OhioIon/zynqFC/_hw/HOWTO.md

/// Open the KiCad project ///
- Open the project file zynqAIO.pro with KiCad 5.0.2
