OhioIon/zynqFC/_sw/HOWTO.md

/// Recreate SDK project after fresh git clone ///
- Please execute the steps in _fpga/HOWTO.md first (recreate project, generate bitstream, export to SDK)
- import the standalone_bsp_0 project 
- Wait until build of BSP sources is success!!!
- Now import the app (flight controller) and fsbl (bootloader from Xilinx) into Eclipse/SDK
