OhioIon/zynqFC/_hw/zynqAIO_CAM.sch

## KiCad design _hw/zynqAIO_CAM.sch (2018-11-11)

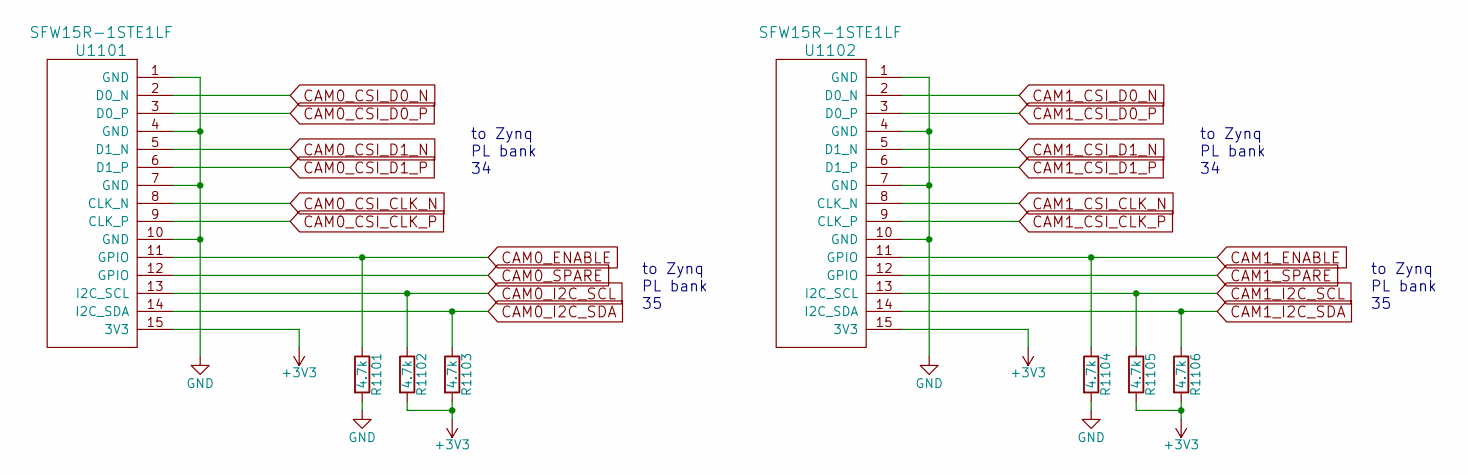
[picture p1: schematic zynqAIO_CAM.sch]

Parts:
R1101, R1102, R1103, R1104, R1105, R1106: 4.7k
U1101, U1102: SFW15R-1STE1LF

Connections:
+3V3: R1102.2, R1103.2, R1105.2, R1106.2, U1101.15 (3V3), U1102.15 (3V3)
CAM0_CSI_CLK_N: U1101.8 (CLK_N)
CAM0_CSI_CLK_P: U1101.9 (CLK_P)
CAM0_CSI_D0_N: U1101.2 (D0_N)
CAM0_CSI_D0_P: U1101.3 (D0_P)
CAM0_CSI_D1_N: U1101.5 (D1_N)
CAM0_CSI_D1_P: U1101.6 (D1_P)
CAM0_ENABLE: R1101.1, U1101.11 (GPIO)
CAM0_I2C_SCL: R1102.1, U1101.13 (I2C_SCL)
CAM0_I2C_SDA: R1103.1, U1101.14 (I2C_SDA)
CAM0_SPARE: U1101.12 (GPIO)
CAM1_CSI_CLK_N: U1102.8 (CLK_N)
CAM1_CSI_CLK_P: U1102.9 (CLK_P)
CAM1_CSI_D0_N: U1102.2 (D0_N)
CAM1_CSI_D0_P: U1102.3 (D0_P)
CAM1_CSI_D1_N: U1102.5 (D1_N)
CAM1_CSI_D1_P: U1102.6 (D1_P)
CAM1_ENABLE: R1104.1, U1102.11 (GPIO)
CAM1_I2C_SCL: R1105.1, U1102.13 (I2C_SCL)
CAM1_I2C_SDA: R1106.1, U1102.14 (I2C_SDA)
CAM1_SPARE: U1102.12 (GPIO)
GND: R1101.2, R1104.2, U1101.1 (GND), U1101.4 (GND), U1101.7 (GND), U1101.10 (GND), U1102.1 (GND), U1102.4 (GND), U1102.7 (GND), U1102.10 (GND)

Notes on the sheet:
to Zynq PL bank 35
to Zynq PL bank 34
