OhioIon/zynqFC/_hw/zynqAIO_IMU.sch

## KiCad design _hw/zynqAIO_IMU.sch (2019-08-02)

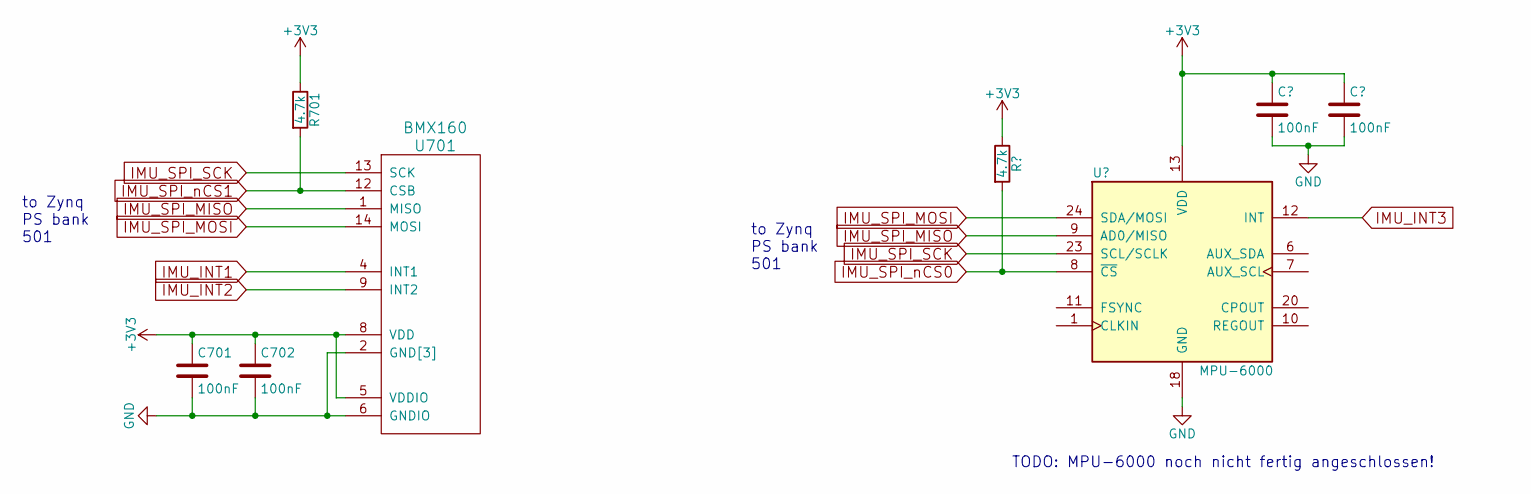
[picture p2: schematic zynqAIO_IMU.sch]

Parts:
C701, C702: 100nF
R701: 4.7k
U701: BMX160

Connections:
+3V3: C701.1, C702.1, R701.1, U701.5 (VDDIO), U701.8 (VDD)
GND: C701.2, C702.2, U701.2 (GND[3]), U701.3 (GND[3]), U701.6 (GNDIO), U701.7 (GND[3])
IMU_INT1: U701.4 (INT1)
IMU_INT2: U701.9 (INT2)
IMU_SPI_MISO: U701.1 (MISO)
IMU_SPI_MOSI: U701.14 (MOSI)
IMU_SPI_SCK: U701.13 (SCK)
IMU_SPI_nCS1: R701.2, U701.12 (CSB)

Notes on the sheet:
to Zynq PS bank 501
TODO: MPU-6000 noch nicht fertig angeschlossen!
