OhioIon/zynqFC/_hw/zynqAIO_Motor.sch

## KiCad design _hw/zynqAIO_Motor.sch (2018-11-11)

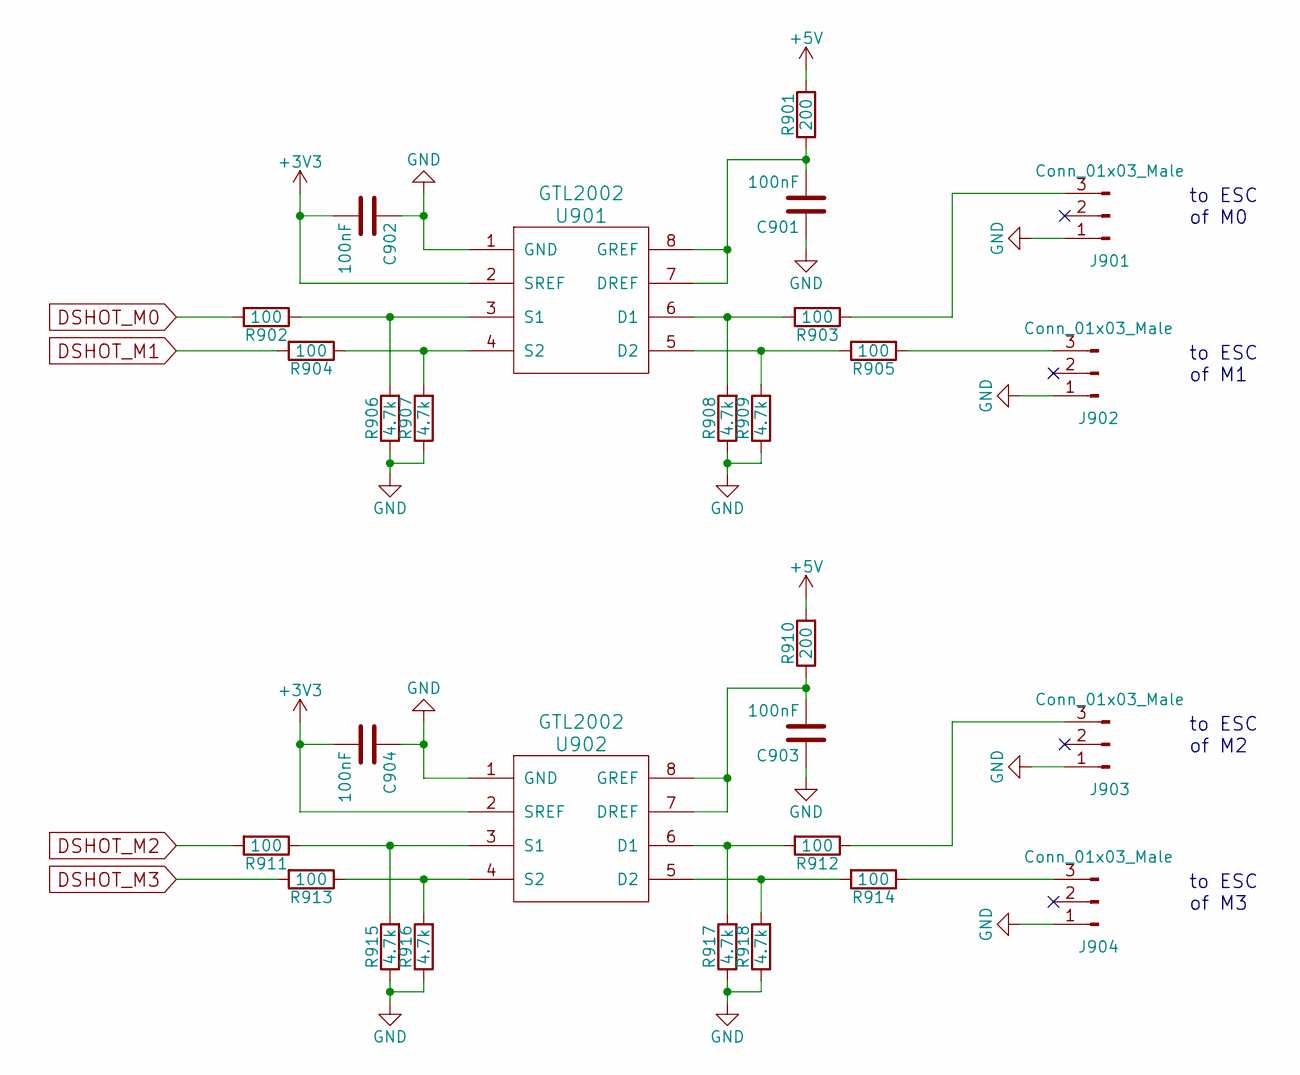
[picture p3: schematic zynqAIO_Motor.sch]

Parts:
C901, C902, C903, C904: 100nF
J901, J902, J903, J904: Conn_01x03_Male
R901, R910: 200
R902, R903, R904, R905, R911, R912, R913, R914: 100
R906, R907, R908, R909, R915, R916, R917, R918: 4.7k
U901, U902: GTL2002

Connections:
+3V3: C902.2, C904.2, U901.2 (SREF), U902.2 (SREF)
+5V: R901.2, R910.2
DSHOT_M0: R902.2
DSHOT_M1: R904.2
DSHOT_M2: R911.2
DSHOT_M3: R913.2
GND: C901.1, C902.1, C903.1, C904.1, J901.1, J902.1, J903.1, J904.1, R906.1, R907.1, R908.1, R909.1, R915.1, R916.1, R917.1, R918.1, U901.1 (GND), U902.1 (GND)
unnamed: C901.2, R901.1, U901.7 (DREF), U901.8 (GREF)
unnamed: C903.2, R910.1, U902.7 (DREF), U902.8 (GREF)
unnamed: J901.3, R903.1
unnamed: J902.3, R905.1
unnamed: J903.3, R912.1
unnamed: J904.3, R914.1
unnamed: R902.1, R906.2, U901.3 (S1)
unnamed: R903.2, R908.2, U901.6 (D1)
unnamed: R904.1, R907.2, U901.4 (S2)
unnamed: R905.2, R909.2, U901.5 (D2)
unnamed: R911.1, R915.2, U902.3 (S1)
unnamed: R912.2, R917.2, U902.6 (D1)
unnamed: R913.1, R916.2, U902.4 (S2)
unnamed: R914.2, R918.2, U902.5 (D2)

Notes on the sheet:
to ESC of M0
to ESC of M1
to ESC of M2
to ESC of M3
