OhioIon/zynqFC/_hw/zynqAIO_RAM.sch

## KiCad design _hw/zynqAIO_RAM.sch (2019-08-02)

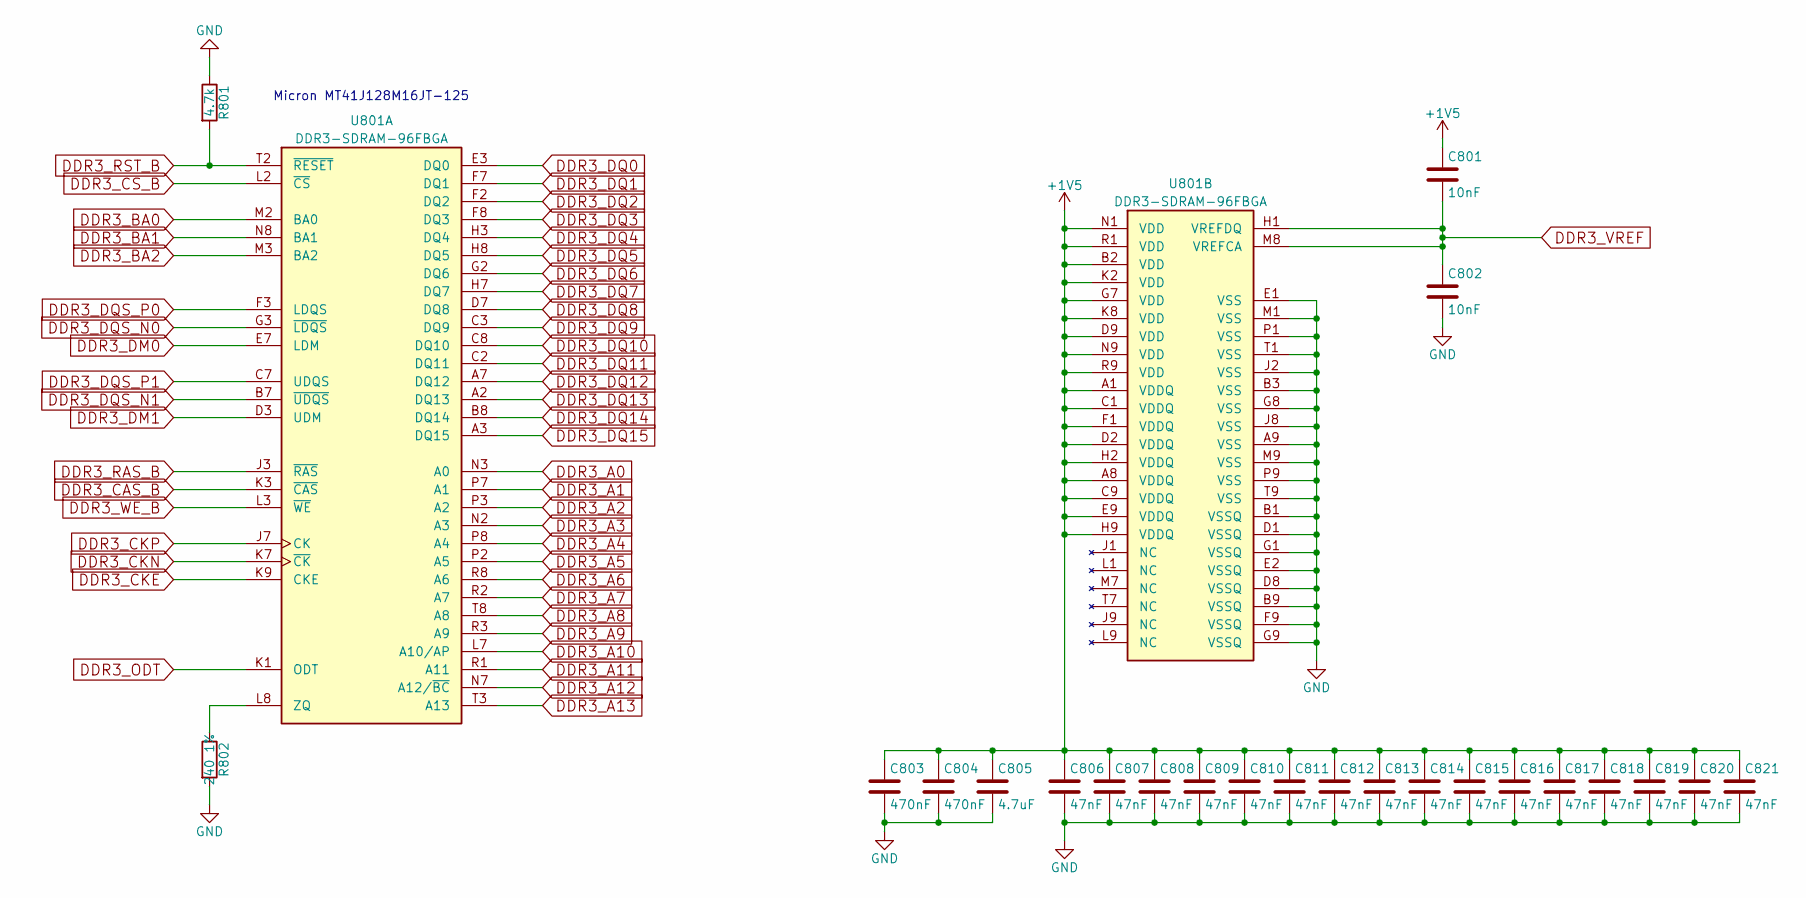
[picture p4: schematic zynqAIO_RAM.sch]

Parts:
C801, C802: 10nF
C803, C804: 470nF
C805: 4.7uF
C806, C807, C808, C809, C810, C811, C812, C813, C814, C815, C816, C817, C818, C819, C820, C821: 47nF
R801: 4.7k
R802: 240 1%
U801: DDR3-SDRAM-96FBGA; FBGA-96-DDR3-SDRAM

Connections:
+1V5: C801.1, C803.1, C804.1, C805.1, C806.1, C807.1, C808.1, C809.1, C810.1, C811.1, C812.1, C813.1, C814.1, C815.1, C816.1, C817.1, C818.1, C819.1, C820.1, C821.1, U801.A1 (VDDQ), U801.A8 (VDDQ), U801.B2 (VDD), U801.C1 (VDDQ), U801.C9 (VDDQ), U801.D2 (VDDQ), U801.D9 (VDD), U801.E9 (VDDQ), U801.F1 (VDDQ), U801.G7 (VDD), U801.H2 (VDDQ), U801.H9 (VDDQ), U801.K2 (VDD), U801.K8 (VDD), U801.N1 (VDD), U801.N9 (VDD), U801.R1 (A11), U801.R9 (VDD)
DDR3_A0: U801.N3 (A0)
DDR3_A1: U801.P7 (A1)
DDR3_A2: U801.P3 (A2)
DDR3_A3: U801.N2 (A3)
DDR3_A4: U801.P8 (A4)
DDR3_A5: U801.P2 (A5)
DDR3_A6: U801.R8 (A6)
DDR3_A7: U801.R2 (A7)
DDR3_A8: U801.T8 (A8)
DDR3_A9: U801.R3 (A9)
DDR3_A10: U801.L7 (A10/AP)
DDR3_A11: U801.R1 (A11)
DDR3_A12: U801.N7 (A12/~BC)
DDR3_A13: U801.T3 (A13)
DDR3_BA0: U801.M2 (BA0)
DDR3_BA1: U801.N8 (BA1)
DDR3_BA2: U801.M3 (BA2)
DDR3_CAS_B: U801.K3 (~CAS)
DDR3_CKE: U801.K9 (CKE)
DDR3_CKN: U801.K7 (~CK)
DDR3_CKP: U801.J7 (CK)
DDR3_CS_B: U801.L2 (~CS)
DDR3_DM0: U801.E7 (LDM)
DDR3_DM1: U801.D3 (UDM)
DDR3_DQ0: U801.E3 (DQ0)
DDR3_DQ1: U801.F7 (DQ1)
DDR3_DQ2: U801.F2 (DQ2)
DDR3_DQ3: U801.F8 (DQ3)
DDR3_DQ4: U801.H3 (DQ4)
DDR3_DQ5: U801.H8 (DQ5)
DDR3_DQ6: U801.G2 (DQ6)
DDR3_DQ7: U801.H7 (DQ7)
DDR3_DQ8: U801.D7 (DQ8)
DDR3_DQ9: U801.C3 (DQ9)
DDR3_DQ10: U801.C8 (DQ10)
DDR3_DQ11: U801.C2 (DQ11)
DDR3_DQ12: U801.A7 (DQ12)
DDR3_DQ13: U801.A2 (DQ13)
DDR3_DQ14: U801.B8 (DQ14)
DDR3_DQ15: U801.A3 (DQ15)
DDR3_DQS_N0: U801.G3 (~LDQS)
DDR3_DQS_N1: U801.B7 (~UDQS)
DDR3_DQS_P0: U801.F3 (LDQS)
DDR3_DQS_P1: U801.C7 (UDQS)
DDR3_ODT: U801.K1 (ODT)
DDR3_RAS_B: U801.J3 (~RAS)
DDR3_RST_B: R801.2, U801.T2 (~RESET)
DDR3_VREF: C801.2, C802.1, U801.H1 (VREFDQ), U801.M8 (VREFCA)
DDR3_WE_B: U801.L3 (~WE)
GND: C802.2, C803.2, C804.2, C805.2, C806.2, C807.2, C808.2, C809.2, C810.2, C811.2, C812.2, C813.2, C814.2, C815.2, C816.2, C817.2, C818.2, C819.2, C820.2, C821.2, R801.1, R802.2, U801.A9 (VSS), U801.B1 (VSSQ), U801.B3 (VSS), U801.B9 (VSSQ), U801.D1 (VSSQ), U801.D8 (VSSQ), U801.E1 (VSS), U801.E2 (VSSQ), U801.F9 (VSSQ), U801.G1 (VSSQ), U801.G8 (VSS), U801.G9 (VSSQ), U801.J2 (VSS), U801.J8 (VSS), U801.M1 (VSS), U801.M9 (VSS), U801.P1 (VSS), U801.P9 (VSS), U801.T1 (VSS), U801.T9 (VSS)
unnamed: R802.1, U801.L8 (ZQ)

Notes on the sheet:
Micron MT41J128M16JT-125
