OhioIon/zynqFC/_hw/zynqAIO_ROM.sch

## KiCad design _hw/zynqAIO_ROM.sch (2019-08-02)

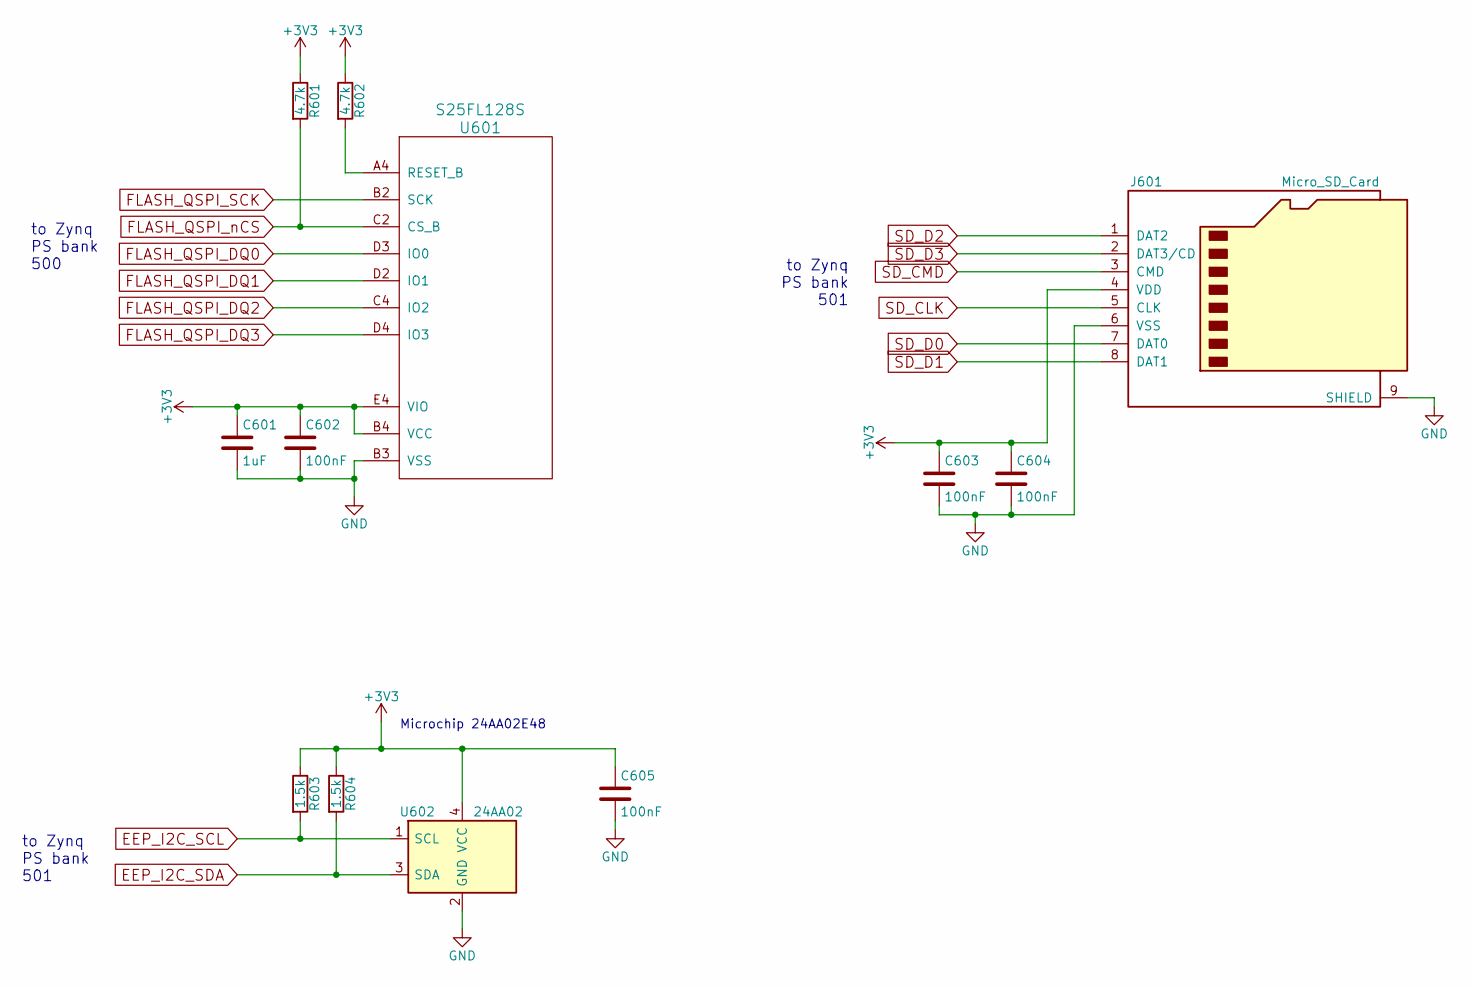
[picture p5: schematic zynqAIO_ROM.sch]

Parts:
C601: 1uF
C602, C603, C604, C605: 100nF
J601: Micro_SD_Card
R601, R602: 4.7k
R603, R604: 1.5k
U601: S25FL128S
U602: 24AA02; SOT-23-5

Connections:
+3V3: C601.1, C602.1, C603.1, C604.1, C605.1, J601.4 (VDD), R601.1, R602.1, R603.1, R604.1, U601.B4 (VCC), U601.E4 (VIO), U602.4 (VCC)
EEP_I2C_SCL: R603.2, U602.1 (SCL)
EEP_I2C_SDA: R604.2, U602.3 (SDA)
FLASH_QSPI_DQ0: U601.D3 (IO0)
FLASH_QSPI_DQ1: U601.D2 (IO1)
FLASH_QSPI_DQ2: U601.C4 (IO2)
FLASH_QSPI_DQ3: U601.D4 (IO3)
FLASH_QSPI_SCK: U601.B2 (SCK)
FLASH_QSPI_nCS: R601.2, U601.C2 (CS_B)
GND: C601.2, C602.2, C603.2, C604.2, C605.2, J601.6 (VSS), J601.9 (SHIELD), U601.B3 (VSS), U602.2 (GND)
unnamed: R602.2, U601.A4 (RESET_B)
SD_CLK: J601.5 (CLK)
SD_CMD: J601.3 (CMD)
SD_D0: J601.7 (DAT0)
SD_D1: J601.8 (DAT1)
SD_D2: J601.1 (DAT2)
SD_D3: J601.2 (DAT3/CD)

Notes on the sheet:
to Zynq PS bank 500
to Zynq PS bank 501
to Zynq PS bank 501
Microchip 24AA02E48
