OhioIon/zynqFC/_hw/zynqAIO_TRX.sch

## KiCad design _hw/zynqAIO_TRX.sch (2018-11-11)

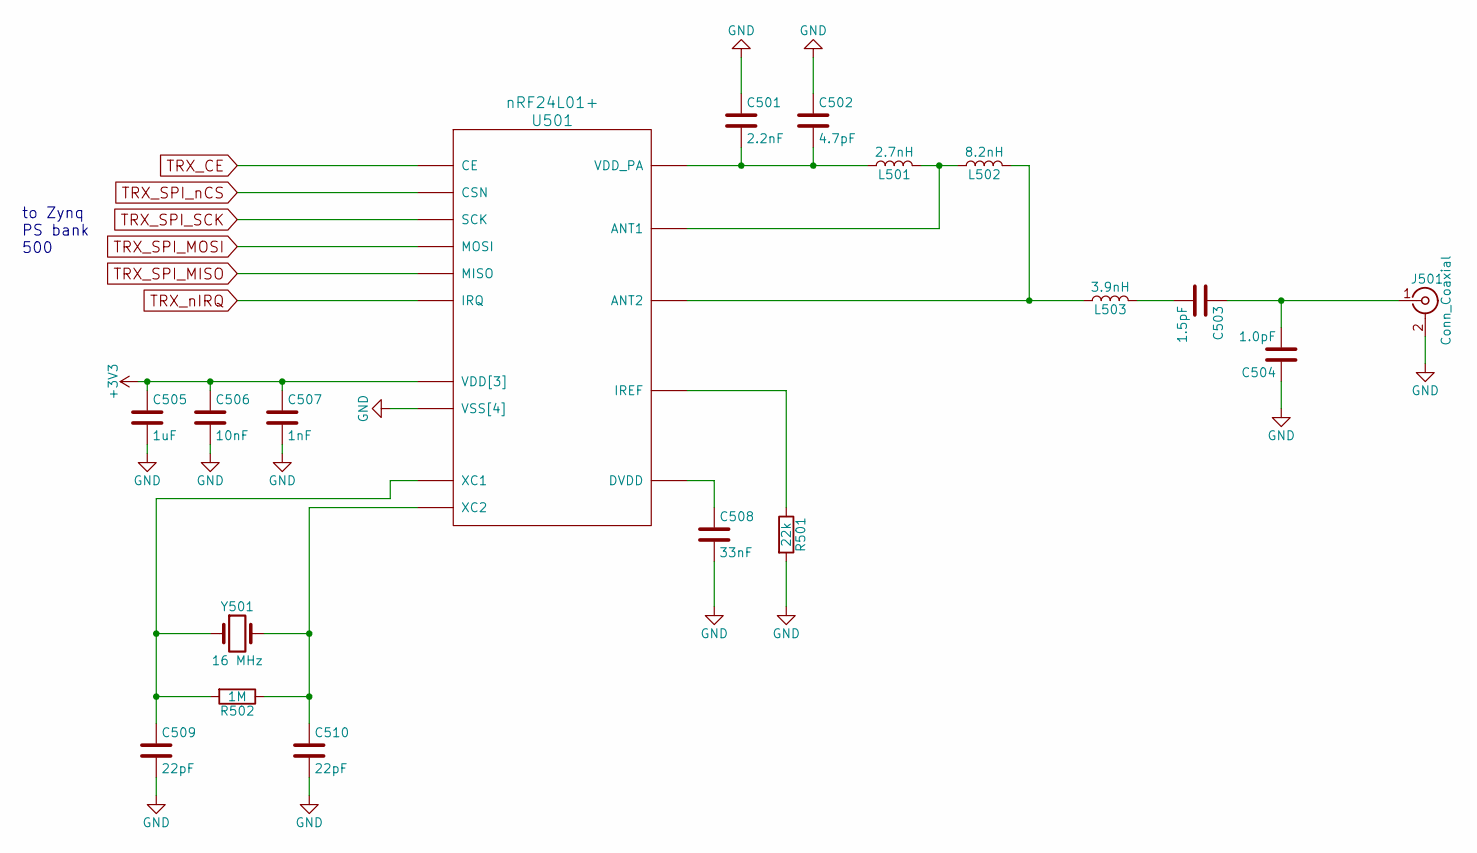
[picture p6: schematic zynqAIO_TRX.sch]

Parts:
C501: 2.2nF
C502: 4.7pF
C503: 1.5pF
C504: 1.0pF
C505: 1uF
C506: 10nF
C507: 1nF
C508: 33nF
C509, C510: 22pF
J501: Conn_Coaxial
L501: 2.7nH
L502: 8.2nH
L503: 3.9nH
R501: 22k
R502: 1M
U501: nRF24L01+
Y501: 16 MHz

Connections:
+3V3: C505.1, C506.1, C507.1, U501.7 (VDD[3]), U501.15 (VDD[3]), U501.18 (VDD[3])
GND: C501.1, C502.1, C504.1, C505.2, C506.2, C507.2, C508.2, C509.2, C510.2, J501.2 (Ext), R501.2, U501.8 (VSS[4]), U501.14 (VSS[4]), U501.17 (VSS), U501.20 (VSS)
unnamed: C501.2, C502.2, L501.1, U501.11 (VDD_PA)
unnamed: C503.1, C504.2, J501.1 (In)
unnamed: C503.2, L503.2
unnamed: C508.1, U501.19 (DVDD)
unnamed: C509.1, R502.2, U501.10 (XC1), Y501.1
unnamed: C510.1, R502.1, U501.9 (XC2), Y501.2
unnamed: L501.2, L502.1, U501.12 (ANT1)
unnamed: L502.2, L503.1, U501.13 (ANT2)
unnamed: R501.1, U501.16 (IREF)
TRX_CE: U501.1 (CE)
TRX_SPI_MISO: U501.5 (MISO)
TRX_SPI_MOSI: U501.4 (MOSI)
TRX_SPI_SCK: U501.3 (SCK)
TRX_SPI_nCS: U501.2 (CSN)
TRX_nIRQ: U501.6 (IRQ)

Notes on the sheet:
to Zynq PS bank 500
