OhioIon/zynqFC/_hw/zynqAIO_ZynqIoBankPl.sch

## KiCad design _hw/zynqAIO_ZynqIoBankPl.sch (2019-07-28)

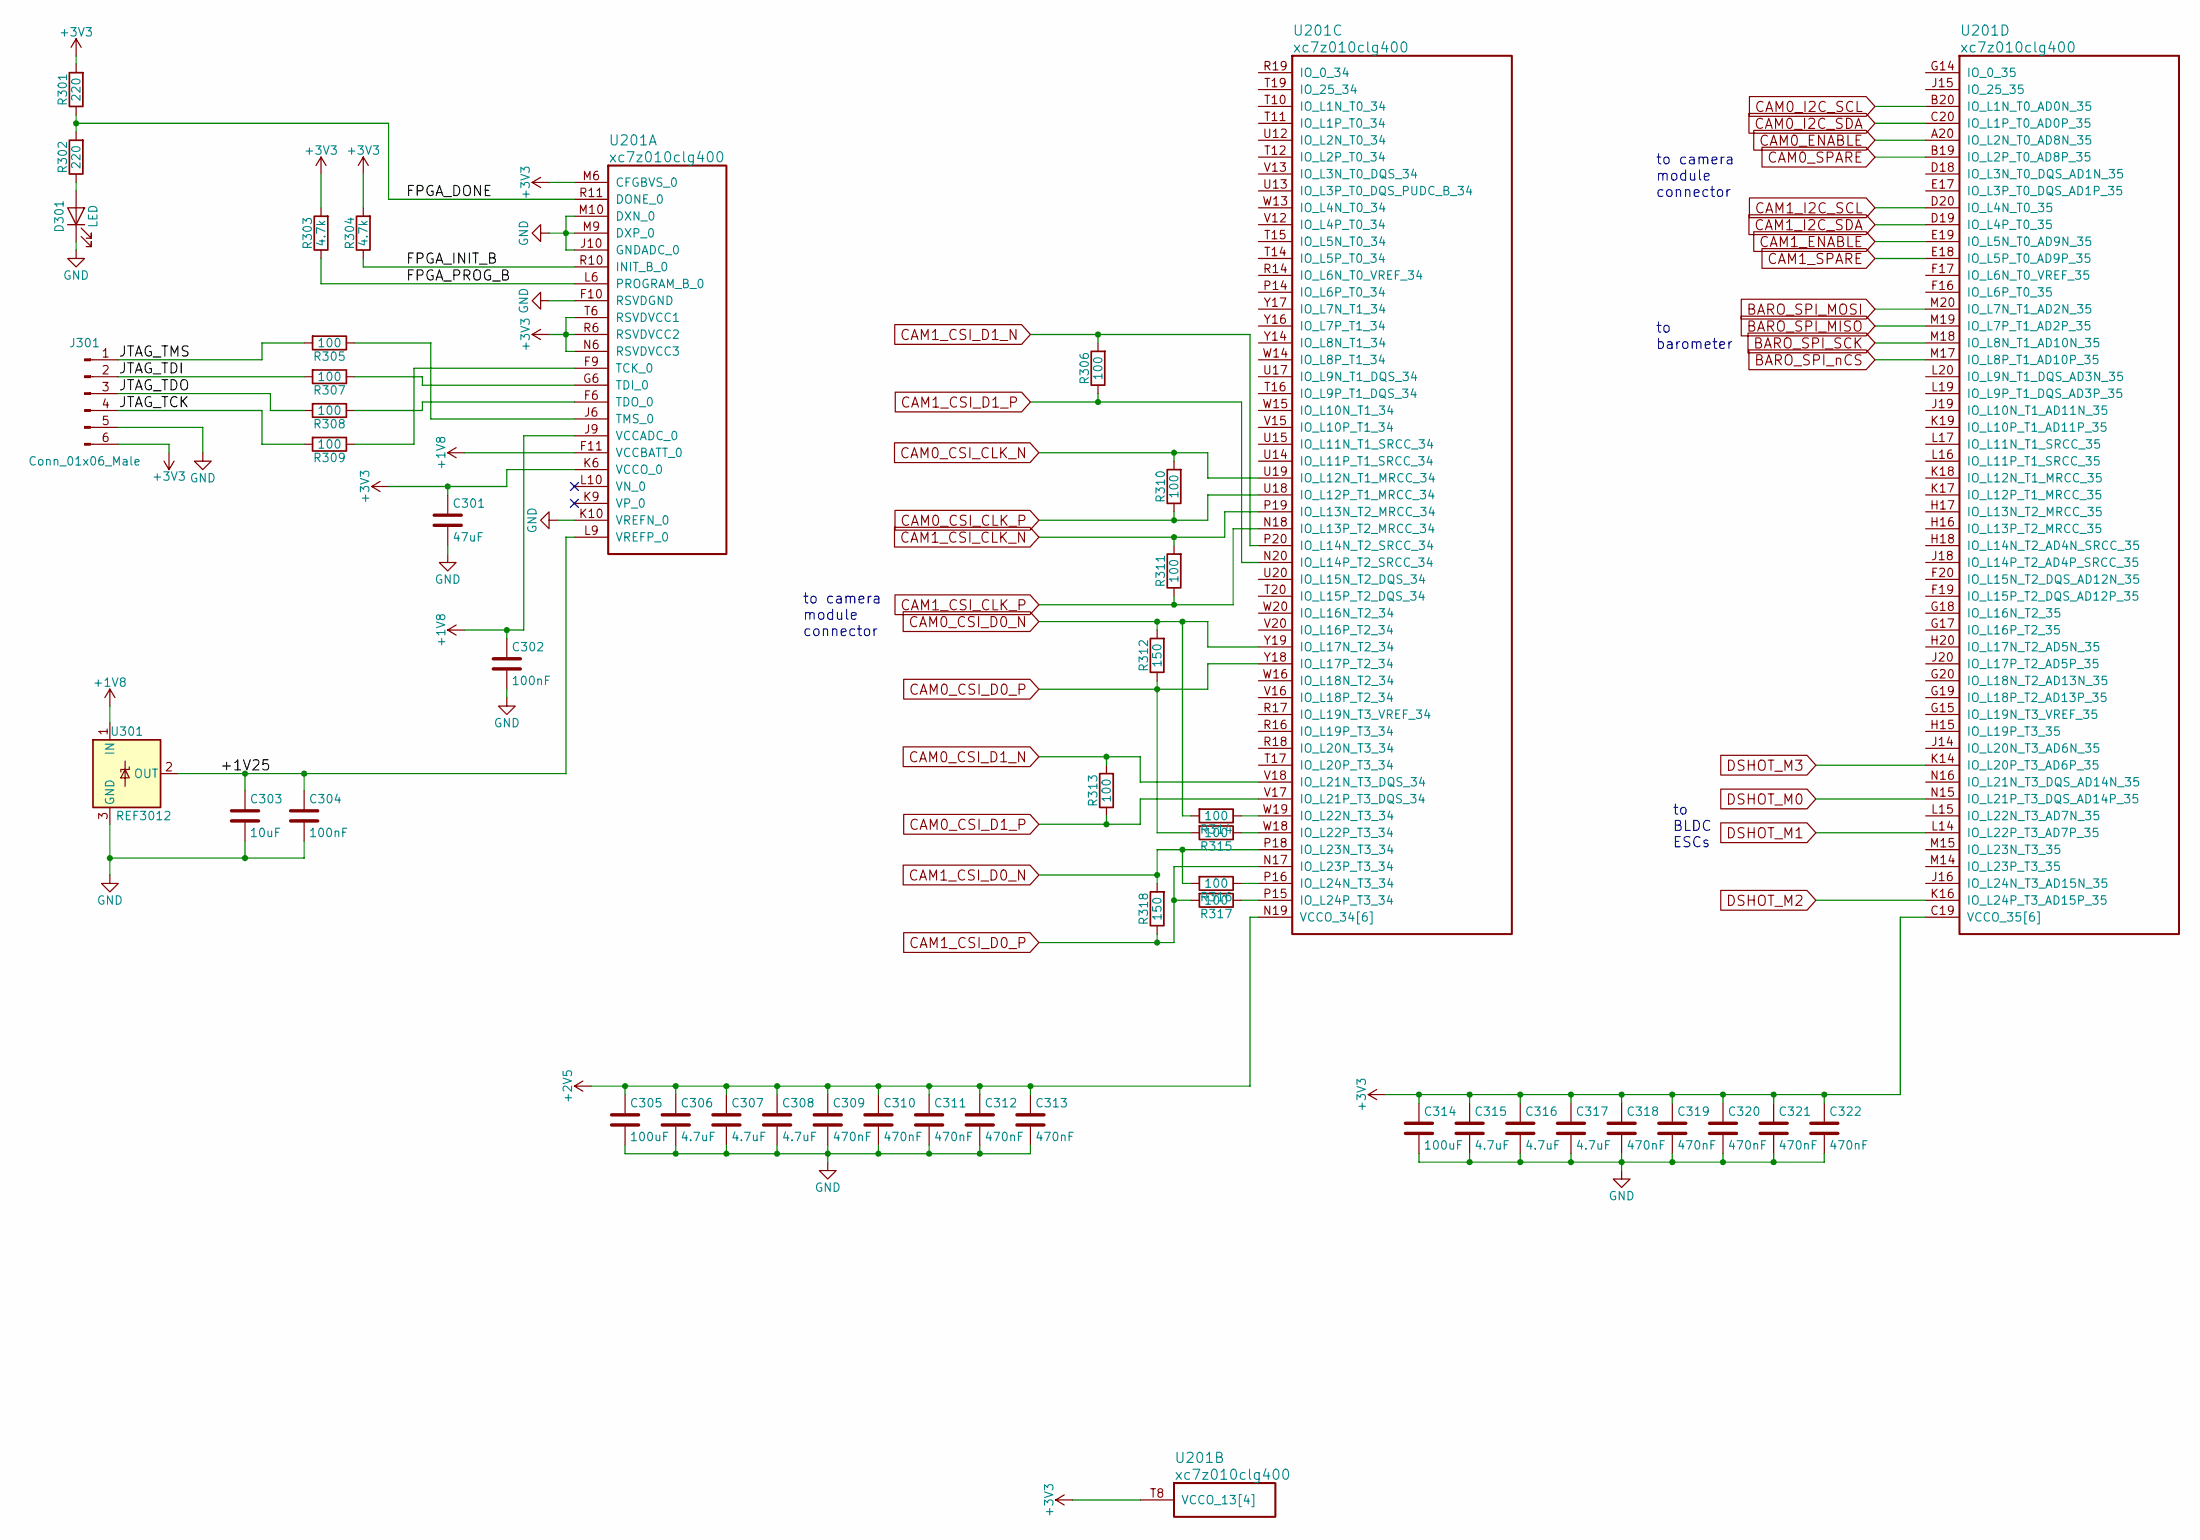
[picture p7: schematic zynqAIO_ZynqIoBankPl.sch]

Parts:
C301: 47uF
C302, C304: 100nF
C303: 10uF
C305, C314: 100uF
C306, C307, C308, C315, C316, C317: 4.7uF
C309, C310, C311, C312, C313, C318, C319, C320, C321, C322: 470nF
D301: LED
J301: Conn_01x06_Male
R301, R302: 220
R303, R304: 4.7k
R305, R306, R307, R308, R309, R310, R311, R313, R314, R315, R316, R317: 100
R312, R318: 150
U201: xc7z010clg400
U301: REF3012; SOT-23

Connections:
+1V8: C302.1, U201.F11 (VCCBATT_0), U201.J9 (VCCADC_0), U301.1 (IN)
+1V25: C303.1, C304.1, U201.L9 (VREFP_0), U301.2 (OUT)
+2V5: C305.1, C306.1, C307.1, C308.1, C309.1, C310.1, C311.1, C312.1, C313.1, U201.N19 (VCCO_34[6]), U201.R15 (VCCO_34[6]), U201.T18 (VCCO_34[6]), U201.V14 (VCCO_34[6]), U201.W17 (VCCO_34[6]), U201.Y20 (VCCO_34[6])
+3V3: C301.1, C314.1, C315.1, C316.1, C317.1, C318.1, C319.1, C320.1, C321.1, C322.1, J301.6, R301.2, R303.2, R304.2, U201.C19 (VCCO_35[6]), U201.F18 (VCCO_35[6]), U201.H14 (VCCO_35[6]), U201.J17 (VCCO_35[6]), U201.K6 (VCCO_0), U201.K20 (VCCO_35[6]), U201.M6 (CFGBVS_0), U201.M16 (VCCO_35[6]), U201.N6 (RSVDVCC3), U201.R6 (RSVDVCC2), U201.T6 (RSVDVCC1), U201.T8 (VCCO_13[4]), U201.U11 (VCCO_13[4]), U201.W7 (VCCO_13[4]), U201.Y10 (VCCO_13[4])
BARO_SPI_MISO: U201.M19 (IO_L7P_T1_AD2P_35)
BARO_SPI_MOSI: U201.M20 (IO_L7N_T1_AD2N_35)
BARO_SPI_SCK: U201.M18 (IO_L8N_T1_AD10N_35)
BARO_SPI_nCS: U201.M17 (IO_L8P_T1_AD10P_35)
CAM0_CSI_CLK_N: R310.2, U201.U19 (IO_L12N_T1_MRCC_34)
CAM0_CSI_CLK_P: R310.1, U201.U18 (IO_L12P_T1_MRCC_34)
CAM0_CSI_D0_N: R312.2, R314.2, U201.Y19 (IO_L17N_T2_34)
CAM0_CSI_D0_P: R312.1, R315.2, U201.Y18 (IO_L17P_T2_34)
CAM0_CSI_D1_N: R313.2, U201.V18 (IO_L21N_T3_DQS_34)
CAM0_CSI_D1_P: R313.1, U201.V17 (IO_L21P_T3_DQS_34)
CAM0_ENABLE: U201.A20 (IO_L2N_T0_AD8N_35)
CAM0_I2C_SCL: U201.B20 (IO_L1N_T0_AD0N_35)
CAM0_I2C_SDA: U201.C20 (IO_L1P_T0_AD0P_35)
CAM0_SPARE: U201.B19 (IO_L2P_T0_AD8P_35)
CAM1_CSI_CLK_N: R311.2, U201.P19 (IO_L13N_T2_MRCC_34)
CAM1_CSI_CLK_P: R311.1, U201.N18 (IO_L13P_T2_MRCC_34)
CAM1_CSI_D0_N: R316.2, R318.2, U201.P18 (IO_L23N_T3_34)
CAM1_CSI_D0_P: R317.2, R318.1, U201.N17 (IO_L23P_T3_34)
CAM1_CSI_D1_N: R306.2, U201.P20 (IO_L14N_T2_SRCC_34)
CAM1_CSI_D1_P: R306.1, U201.N20 (IO_L14P_T2_SRCC_34)
CAM1_ENABLE: U201.E19 (IO_L5N_T0_AD9N_35)
CAM1_I2C_SCL: U201.D20 (IO_L4N_T0_35)
CAM1_I2C_SDA: U201.D19 (IO_L4P_T0_35)
CAM1_SPARE: U201.E18 (IO_L5P_T0_AD9P_35)
DSHOT_M0: U201.N15 (IO_L21P_T3_DQS_AD14P_35)
DSHOT_M1: U201.L14 (IO_L22P_T3_AD7P_35)
DSHOT_M2: U201.K16 (IO_L24P_T3_AD15P_35)
DSHOT_M3: U201.K14 (IO_L20P_T3_AD6P_35)
FPGA_DONE: R301.1, R302.2, U201.R11 (DONE_0)
FPGA_INIT_B: R304.1, U201.R10 (INIT_B_0)
FPGA_PROG_B: R303.1, U201.L6 (PROGRAM_B_0)
GND: C301.2, C302.2, C303.2, C304.2, C305.2, C306.2, C307.2, C308.2, C309.2, C310.2, C311.2, C312.2, C313.2, C314.2, C315.2, C316.2, C317.2, C318.2, C319.2, C320.2, C321.2, C322.2, D301.1 (K), J301.5, U201.F10 (RSVDGND), U201.J10 (GNDADC_0), U201.K10 (VREFN_0), U201.M9 (DXP_0), U201.M10 (DXN_0), U301.3 (GND)
JTAG_TCK: J301.4, R309.2
JTAG_TDI: J301.2, R307.2
JTAG_TDO: J301.3, R308.2
JTAG_TMS: J301.1, R305.2
unnamed: D301.2 (A), R302.1
unnamed: R305.1, U201.J6 (TMS_0)
unnamed: R307.1, U201.G6 (TDI_0)
unnamed: R308.1, U201.F6 (TDO_0)
unnamed: R309.1, U201.F9 (TCK_0)
unnamed: R314.1, U201.W19 (IO_L22N_T3_34)
unnamed: R315.1, U201.W18 (IO_L22P_T3_34)
unnamed: R316.1, U201.P16 (IO_L24N_T3_34)
unnamed: R317.1, U201.P15 (IO_L24P_T3_34)

Notes on the sheet:
to camera module connector
to barometer
to BLDC ESCs
