OhioIon/zynqFC/_hw/zynqAIO_ZynqIoBankPs.sch

## KiCad design _hw/zynqAIO_ZynqIoBankPs.sch (2019-08-02)

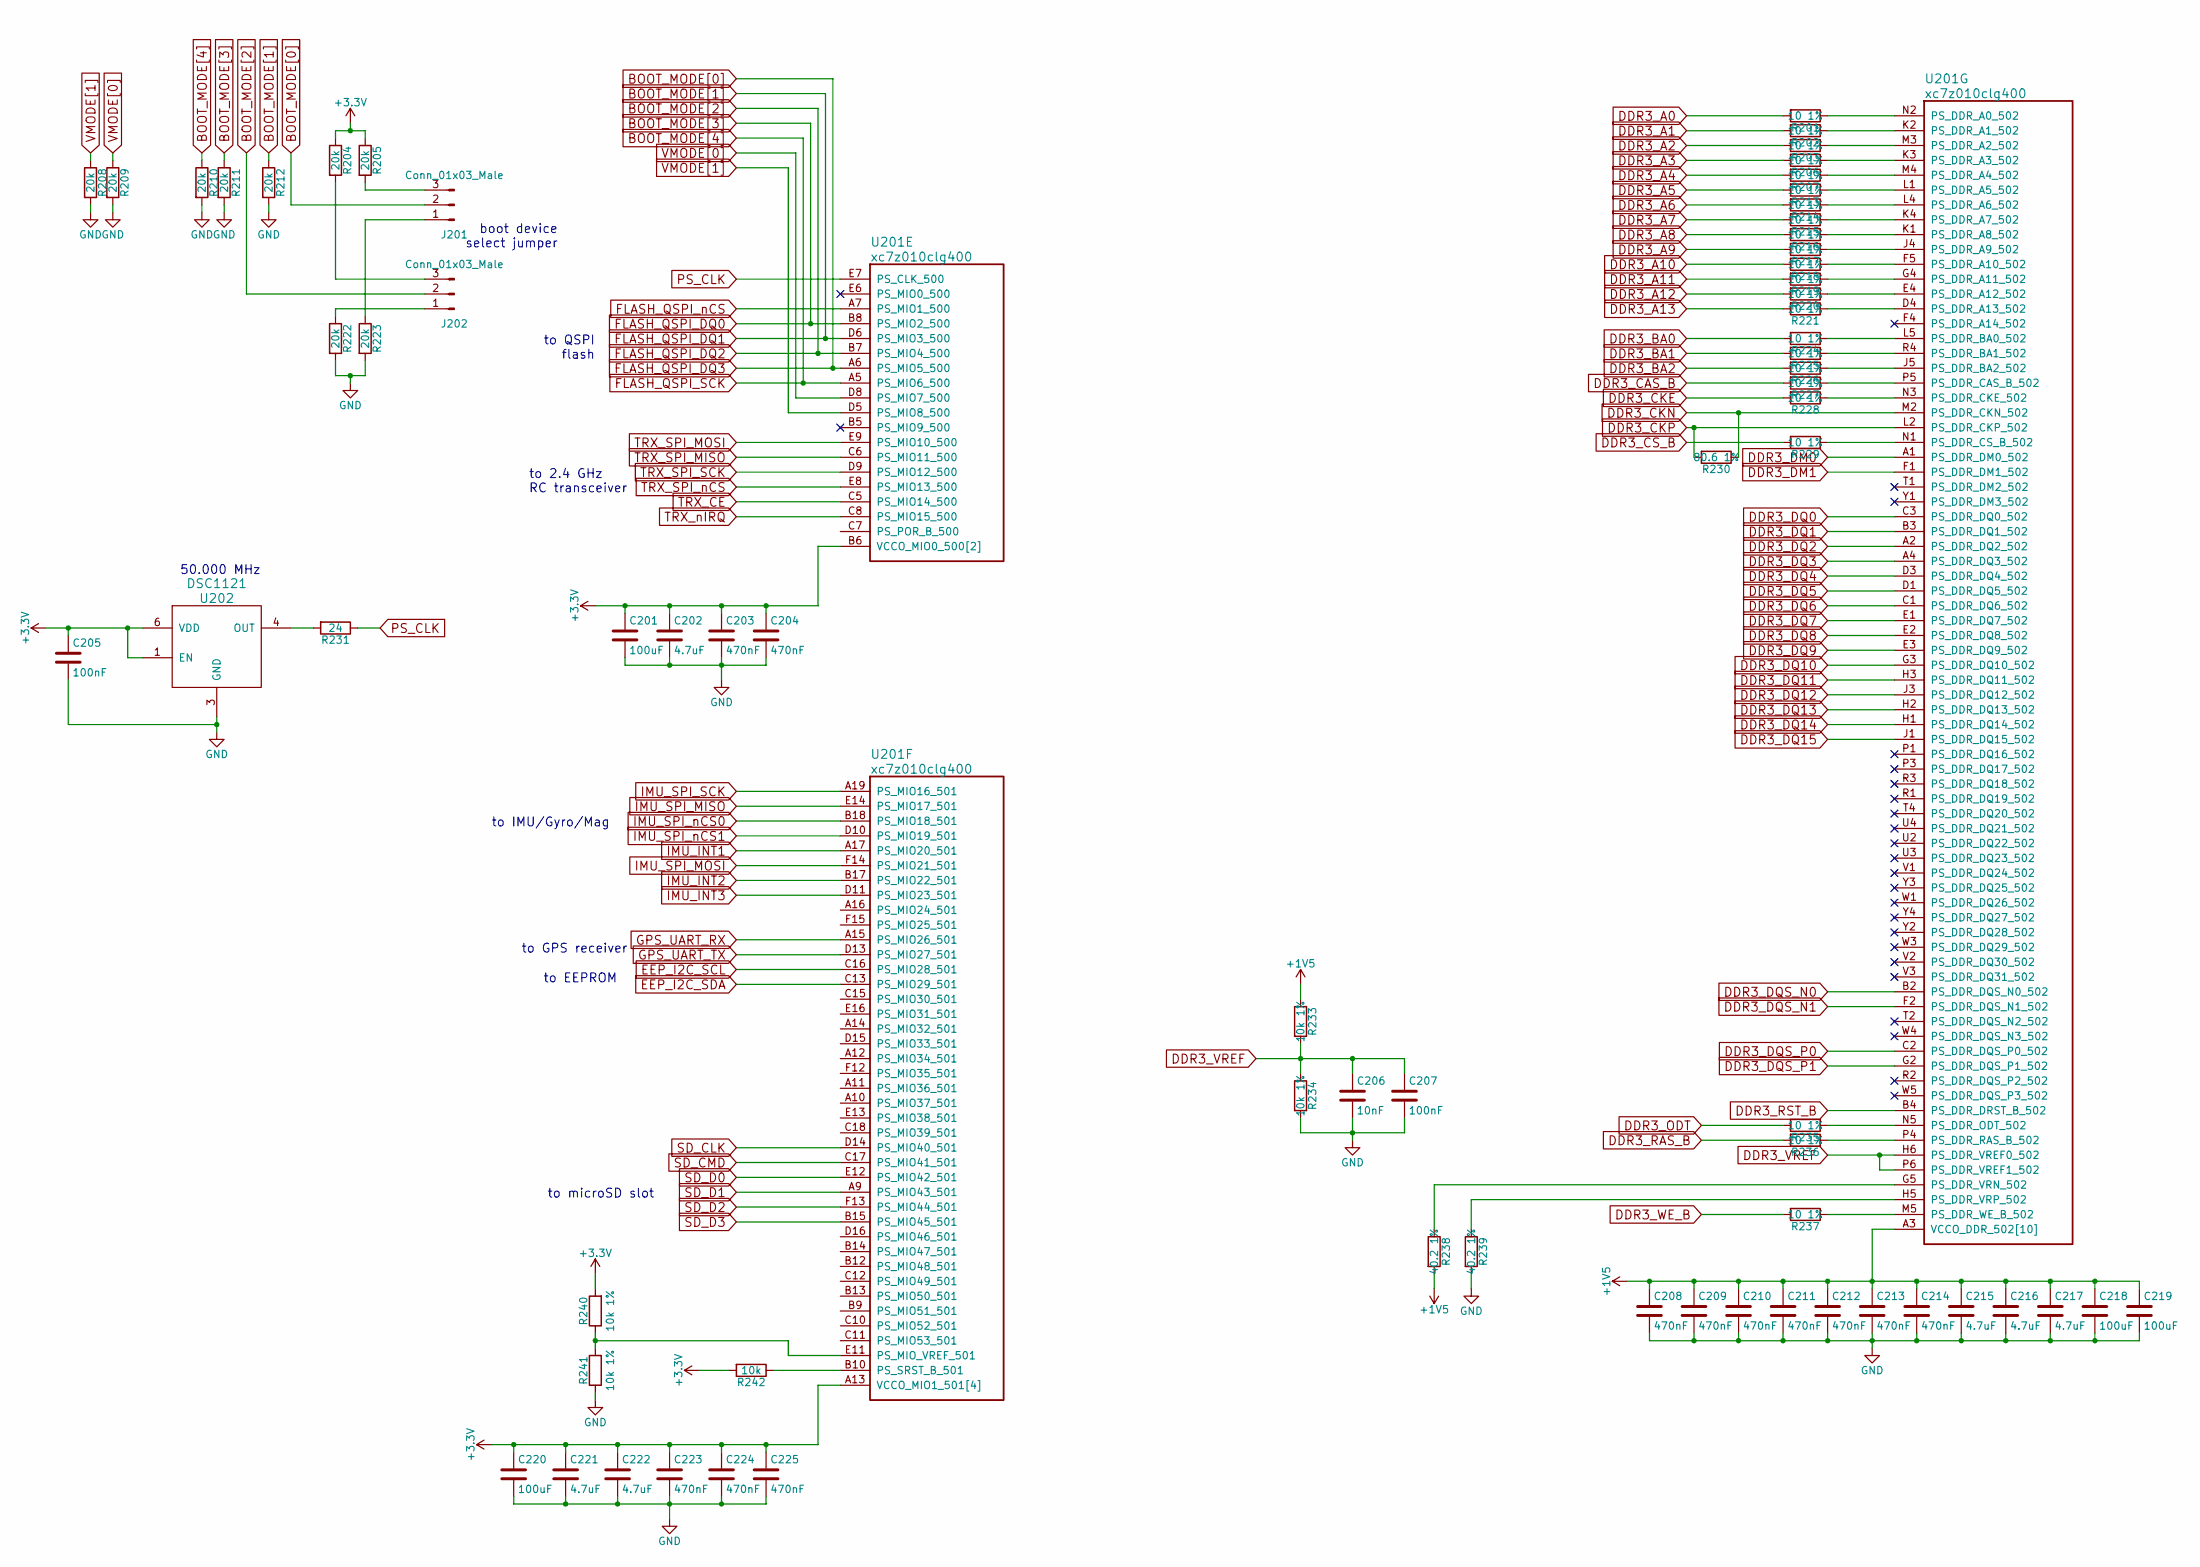
[picture p8: schematic zynqAIO_ZynqIoBankPs.sch]

Parts:
C201, C218, C219, C220: 100uF
C202, C215, C216, C217, C221, C222: 4.7uF
C203, C204, C208, C209, C210, C211, C212, C213, C214, C223, C224, C225: 470nF
C205, C207: 100nF
C206: 10nF
J201, J202: Conn_01x03_Male
R201, R202, R203, R206, R207, R213, R214, R215, R216, R217, R218, R219, R220, R221, R224, R225, R226, R227, R228, R229, R235, R236, R237: 10 1%
R204, R205, R208, R209, R210, R211, R212, R222, R223: 20k
R230: 80.6 1%
R231: 24
R233, R234, R240, R241: 10k 1%
R238, R239: 40.2 1%
R242: 10k
U201: xc7z010clg400
U202: DSC1121

Connections:
+1V5: C208.1, C209.1, C210.1, C211.1, C212.1, C213.1, C214.1, C215.1, C216.1, C217.1, C218.1, C219.1, R233.1, R238.2, U201.A3 (VCCO_DDR_502[10]), U201.D2 (VCCO_DDR_502[10]), U201.E5 (VCCO_DDR_502[10]), U201.G1 (VCCO_DDR_502[10]), U201.H4 (VCCO_DDR_502[10]), U201.L3 (VCCO_DDR_502[10]), U201.P2 (VCCO_DDR_502[10]), U201.R5 (VCCO_DDR_502[10]), U201.U1 (VCCO_DDR_502[10]), U201.V4 (VCCO_DDR_502[10])
+3.3V: C201.1, C202.1, C203.1, C204.1, C205.1, C220.1, C221.1, C222.1, C223.1, C224.1, C225.1, R204.1, R205.1, R240.2, R242.2, U201.A13 (VCCO_MIO1_501[4]), U201.B6 (VCCO_MIO0_500[2]), U201.B16 (VCCO_MIO1_501[4]), U201.D7 (VCCO_MIO0_500[2]), U201.D12 (VCCO_MIO1_501[4]), U201.E15 (VCCO_MIO1_501[4]), U202.1 (EN), U202.6 (VDD)
BOOT_MODE[0]: J201.2, U201.A6 (PS_MIO5_500)
BOOT_MODE[1]: R212.1, U201.D6 (PS_MIO3_500)
BOOT_MODE[2]: J202.2, U201.B7 (PS_MIO4_500)
BOOT_MODE[3]: R211.1, U201.B8 (PS_MIO2_500)
BOOT_MODE[4]: R210.1, U201.A5 (PS_MIO6_500)
DDR3_A0: R201.2
DDR3_A1: R202.2
DDR3_A2: R203.2
DDR3_A3: R206.2
DDR3_A4: R207.2
DDR3_A5: R213.2
DDR3_A6: R214.2
DDR3_A7: R215.2
DDR3_A8: R216.2
DDR3_A9: R217.2
DDR3_A10: R218.2
DDR3_A11: R219.2
DDR3_A12: R220.2
DDR3_A13: R221.2
DDR3_BA0: R224.2
DDR3_BA1: R225.2
DDR3_BA2: R226.2
DDR3_CAS_B: R227.2
DDR3_CKE: R228.2
DDR3_CKN: R230.1, U201.M2 (PS_DDR_CKN_502)
DDR3_CKP: R230.2, U201.L2 (PS_DDR_CKP_502)
DDR3_CS_B: R229.2
DDR3_DM0: U201.A1 (PS_DDR_DM0_502)
DDR3_DM1: U201.F1 (PS_DDR_DM1_502)
DDR3_DQ0: U201.C3 (PS_DDR_DQ0_502)
DDR3_DQ1: U201.B3 (PS_DDR_DQ1_502)
DDR3_DQ2: U201.A2 (PS_DDR_DQ2_502)
DDR3_DQ3: U201.A4 (PS_DDR_DQ3_502)
DDR3_DQ4: U201.D3 (PS_DDR_DQ4_502)
DDR3_DQ5: U201.D1 (PS_DDR_DQ5_502)
DDR3_DQ6: U201.C1 (PS_DDR_DQ6_502)
DDR3_DQ7: U201.E1 (PS_DDR_DQ7_502)
DDR3_DQ8: U201.E2 (PS_DDR_DQ8_502)
DDR3_DQ9: U201.E3 (PS_DDR_DQ9_502)
DDR3_DQ10: U201.G3 (PS_DDR_DQ10_502)
DDR3_DQ11: U201.H3 (PS_DDR_DQ11_502)
DDR3_DQ12: U201.J3 (PS_DDR_DQ12_502)
DDR3_DQ13: U201.H2 (PS_DDR_DQ13_502)
DDR3_DQ14: U201.H1 (PS_DDR_DQ14_502)
DDR3_DQ15: U201.J1 (PS_DDR_DQ15_502)
DDR3_DQS_N0: U201.B2 (PS_DDR_DQS_N0_502)
DDR3_DQS_N1: U201.F2 (PS_DDR_DQS_N1_502)
DDR3_DQS_P0: U201.C2 (PS_DDR_DQS_P0_502)
DDR3_DQS_P1: U201.G2 (PS_DDR_DQS_P1_502)
DDR3_ODT: R235.2
DDR3_RAS_B: R236.2
DDR3_RST_B: U201.B4 (PS_DDR_DRST_B_502)
DDR3_VREF: C206.1, C207.1, R233.2, R234.1, U201.H6 (PS_DDR_VREF0_502), U201.P6 (PS_DDR_VREF1_502)
DDR3_WE_B: R237.2
EEP_I2C_SCL: U201.C16 (PS_MIO28_501)
EEP_I2C_SDA: U201.C13 (PS_MIO29_501)
FLASH_QSPI_nCS: U201.A7 (PS_MIO1_500)
GND: C201.2, C202.2, C203.2, C204.2, C205.2, C206.2, C207.2, C208.2, C209.2, C210.2, C211.2, C212.2, C213.2, C214.2, C215.2, C216.2, C217.2, C218.2, C219.2, C220.2, C221.2, C222.2, C223.2, C224.2, C225.2, R208.2, R209.2, R210.2, R211.2, R212.2, R222.2, R223.2, R234.2, R239.2, R241.1, U202.3 (GND)
GPS_UART_RX: U201.A15 (PS_MIO26_501)
GPS_UART_TX: U201.D13 (PS_MIO27_501)
IMU_INT1: U201.A17 (PS_MIO20_501)
IMU_INT2: U201.B17 (PS_MIO22_501)
IMU_INT3: U201.D11 (PS_MIO23_501)
IMU_SPI_MISO: U201.E14 (PS_MIO17_501)
IMU_SPI_MOSI: U201.F14 (PS_MIO21_501)
IMU_SPI_SCK: U201.A19 (PS_MIO16_501)
IMU_SPI_nCS0: U201.B18 (PS_MIO18_501)
IMU_SPI_nCS1: U201.D10 (PS_MIO19_501)
unnamed: J201.1, R223.1
unnamed: J201.3, R205.2
unnamed: J202.1, R222.1
unnamed: J202.3, R204.2
unnamed: R201.1, U201.N2 (PS_DDR_A0_502)
unnamed: R202.1, U201.K2 (PS_DDR_A1_502)
unnamed: R203.1, U201.M3 (PS_DDR_A2_502)
unnamed: R206.1, U201.K3 (PS_DDR_A3_502)
unnamed: R207.1, U201.M4 (PS_DDR_A4_502)
unnamed: R213.1, U201.L1 (PS_DDR_A5_502)
unnamed: R214.1, U201.L4 (PS_DDR_A6_502)
unnamed: R215.1, U201.K4 (PS_DDR_A7_502)
unnamed: R216.1, U201.K1 (PS_DDR_A8_502)
unnamed: R217.1, U201.J4 (PS_DDR_A9_502)
unnamed: R218.1, U201.F5 (PS_DDR_A10_502)
unnamed: R219.1, U201.G4 (PS_DDR_A11_502)
unnamed: R220.1, U201.E4 (PS_DDR_A12_502)
unnamed: R221.1, U201.D4 (PS_DDR_A13_502)
unnamed: R224.1, U201.L5 (PS_DDR_BA0_502)
unnamed: R225.1, U201.R4 (PS_DDR_BA1_502)
unnamed: R226.1, U201.J5 (PS_DDR_BA2_502)
unnamed: R227.1, U201.P5 (PS_DDR_CAS_B_502)
unnamed: R228.1, U201.N3 (PS_DDR_CKE_502)
unnamed: R229.1, U201.N1 (PS_DDR_CS_B_502)
unnamed: R231.2, U202.4 (OUT)
unnamed: R235.1, U201.N5 (PS_DDR_ODT_502)
unnamed: R236.1, U201.P4 (PS_DDR_RAS_B_502)
unnamed: R237.1, U201.M5 (PS_DDR_WE_B_502)
unnamed: R238.1, U201.G5 (PS_DDR_VRN_502)
unnamed: R239.1, U201.H5 (PS_DDR_VRP_502)
unnamed: R240.1, R241.2, U201.E11 (PS_MIO_VREF_501)
unnamed: R242.1, U201.B10 (PS_SRST_B_501)
PS_CLK: R231.1, U201.E7 (PS_CLK_500)
SD_CLK: U201.D14 (PS_MIO40_501)
SD_CMD: U201.C17 (PS_MIO41_501)
SD_D0: U201.E12 (PS_MIO42_501)
SD_D1: U201.A9 (PS_MIO43_501)
SD_D2: U201.F13 (PS_MIO44_501)
SD_D3: U201.B15 (PS_MIO45_501)
TRX_CE: U201.C5 (PS_MIO14_500)
TRX_SPI_MISO: U201.C6 (PS_MIO11_500)
TRX_SPI_MOSI: U201.E9 (PS_MIO10_500)
TRX_SPI_SCK: U201.D9 (PS_MIO12_500)
TRX_SPI_nCS: U201.E8 (PS_MIO13_500)
TRX_nIRQ: U201.C8 (PS_MIO15_500)
VMODE[0]: R209.1, U201.D8 (PS_MIO7_500)
VMODE[1]: R208.1, U201.D5 (PS_MIO8_500)

Notes on the sheet:
to 2.4 GHz RC transceiver
boot device select jumper
to QSPI flash
to microSD slot
to EEPROM
to IMU/Gyro/Mag
to GPS receiver
50.000 MHz
