OhioIon/zynqFC/_hw/zynqAIO_ZynqPower.sch

## KiCad design _hw/zynqAIO_ZynqPower.sch (2018-11-11)

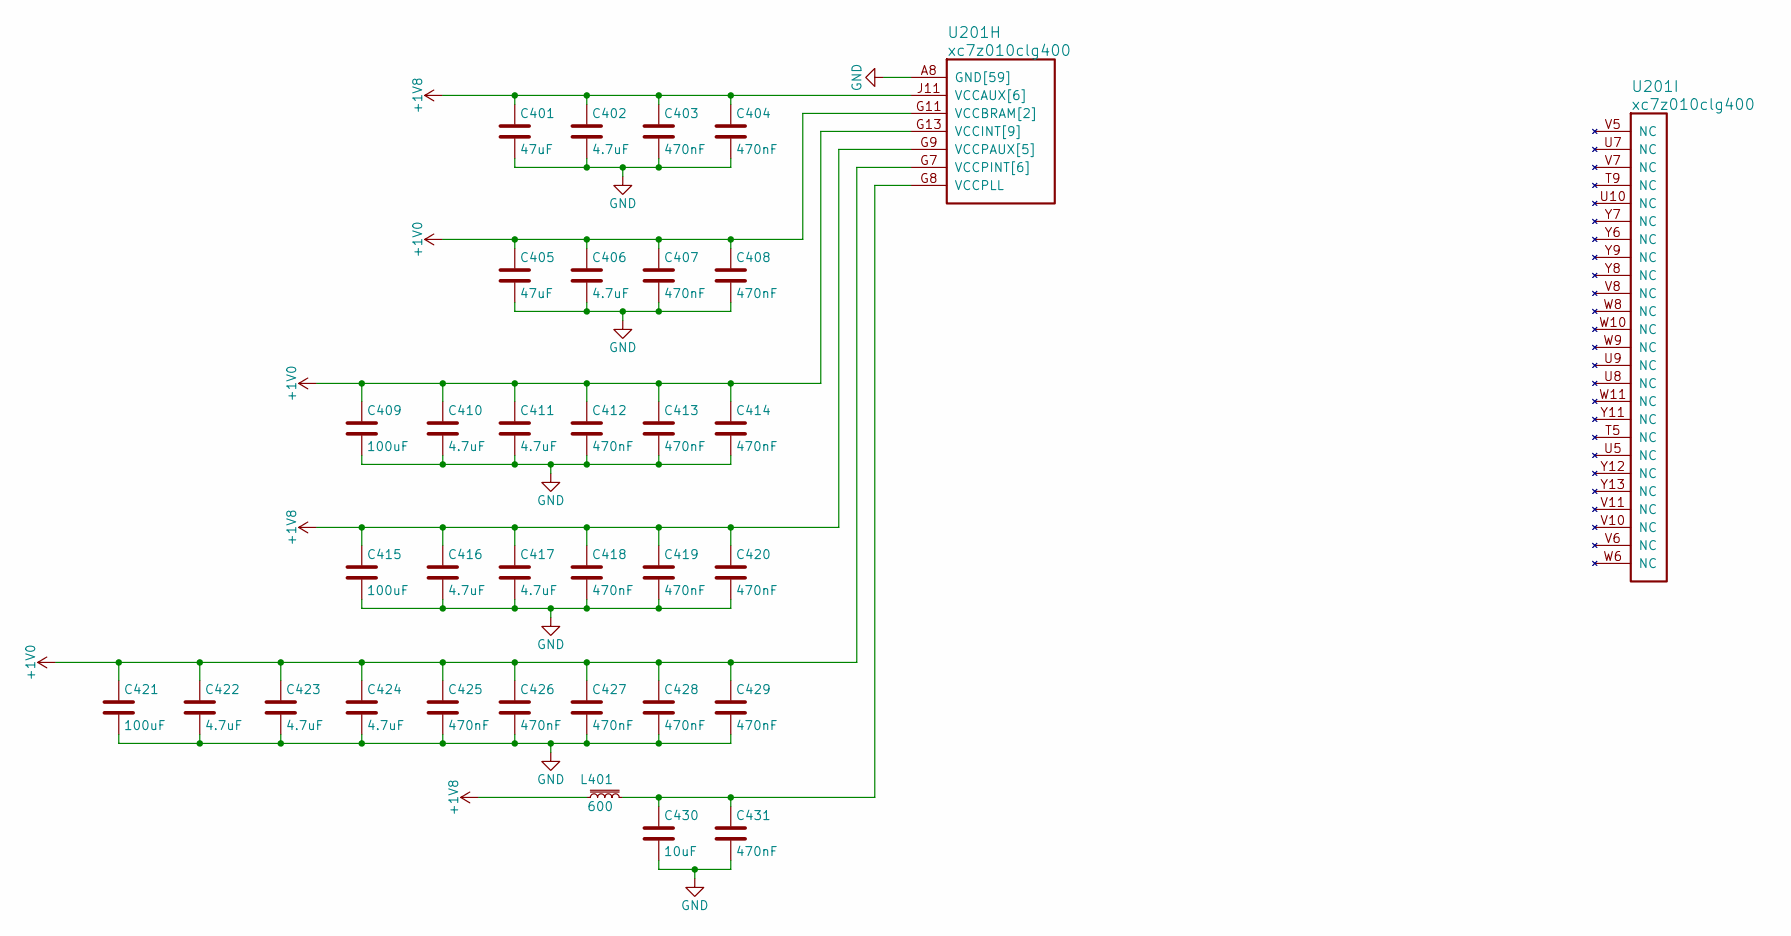
[picture p9: schematic zynqAIO_ZynqPower.sch]

Parts:
C401, C405: 47uF
C402, C406, C410, C411, C416, C417, C422, C423, C424: 4.7uF
C403, C404, C407, C408, C412, C413, C414, C418, C419, C420, C425, C426, C427, C428, C429, C431: 470nF
C409, C415, C421: 100uF
C430: 10uF
L401: 600
U201: xc7z010clg400

Connections:
+1V0: C405.1, C406.1, C407.1, C408.1, C409.1, C410.1, C411.1, C412.1, C413.1, C414.1, C421.1, C422.1, C423.1, C424.1, C425.1, C426.1, C427.1, C428.1, C429.1, U201.G7 (VCCPINT[6]), U201.G11 (VCCBRAM[2]), U201.G13 (VCCINT[9]), U201.H10 (VCCBRAM[2]), U201.H12 (VCCINT[9]), U201.J7 (VCCPINT[6]), U201.J13 (VCCINT[9]), U201.K12 (VCCINT[9]), U201.L7 (VCCPINT[6]), U201.L13 (VCCINT[9]), U201.M12 (VCCINT[9]), U201.N7 (VCCPINT[6]), U201.N13 (VCCINT[9]), U201.P8 (VCCPINT[6]), U201.P12 (VCCINT[9]), U201.R7 (VCCPINT[6]), U201.R13 (VCCINT[9])
+1V8: C401.1, C402.1, C403.1, C404.1, C415.1, C416.1, C417.1, C418.1, C419.1, C420.1, L401.1, U201.F8 (VCCPAUX[5]), U201.G9 (VCCPAUX[5]), U201.H8 (VCCPAUX[5]), U201.J11 (VCCAUX[6]), U201.K8 (VCCPAUX[5]), U201.L11 (VCCAUX[6]), U201.M8 (VCCPAUX[5]), U201.N9 (VCCAUX[6]), U201.N11 (VCCAUX[6]), U201.P10 (VCCAUX[6]), U201.R9 (VCCAUX[6])
GND: C401.2, C402.2, C403.2, C404.2, C405.2, C406.2, C407.2, C408.2, C409.2, C410.2, C411.2, C412.2, C413.2, C414.2, C415.2, C416.2, C417.2, C418.2, C419.2, C420.2, C421.2, C422.2, C423.2, C424.2, C425.2, C426.2, C427.2, C428.2, C429.2, C430.2, C431.2, U201.A8 (GND[59]), U201.A18 (GND[59]), U201.B1 (GND[59]), U201.B11 (GND[59]), U201.C4 (GND[59]), U201.C9 (GND[59]), U201.C14 (GND[59]), U201.D17 (GND[59]), U201.E10 (GND[59]), U201.E20 (GND[59]), U201.F3 (GND[59]), U201.F7 (GND[59]), U201.G10 (GND[59]), U201.G12 (GND[59]), U201.G16 (GND[59]), U201.H7 (GND[59]), U201.H9 (GND[59]), U201.H11 (GND[59]), U201.H13 (GND[59]), U201.H19 (GND[59]), U201.J2 (GND[59]), U201.J8 (GND[59]), U201.J12 (GND[59]), U201.K5 (GND[59]), U201.K7 (GND[59]), U201.K11 (GND[59]), U201.K13 (GND[59]), U201.K15 (GND[59]), U201.L8 (GND[59]), U201.L12 (GND[59]), U201.L18 (GND[59]), U201.M1 (GND[59]), U201.M7 (GND[59]), U201.M11 (GND[59]), U201.M13 (GND[59]), U201.N4 (GND[59]), U201.N8 (GND[59]), U201.N10 (GND[59]), U201.N12 (GND[59]), U201.N14 (GND[59]), U201.P7 (GND[59]), U201.P9 (GND[59]), U201.P11 (GND[59]), U201.P13 (GND[59]), U201.P17 (GND[59]), U201.R8 (GND[59]), U201.R12 (GND[59]), U201.R20 (GND[59]), U201.T3 (GND[59]), U201.T7 (GND[59]), U201.T13 (GND[59]), U201.U6 (GND[59]), U201.U16 (GND[59]), U201.V9 (GND[59]), U201.V19 (GND[59]), U201.W2 (GND[59]), U201.W12 (GND[59]), U201.Y5 (GND[59]), U201.Y15 (GND[59])
unnamed: C430.1, C431.1, L401.2, U201.G8 (VCCPLL)
