OhioIon/zynqFC/_sw/app/_lib/DevInp/mpu6000.h

#ifndef MPU6000_H_
#define MPU6000_H_

#ifdef MPU6000_C
#define MPU6000_SCOPE
#else
#define MPU6000_SCOPE extern
#endif

/****************** Includes ********************/

#include <stdint.h>

/******************* Defines ********************/

/******************** Types *********************/

typedef struct mpu6000_prv_s
{
  int16_t currRate_p1degps_s16; // Current sensor resolution range [0.1 °/s]
  uint8_t buf_au8[6];           // Data transfer buffer

} mpu6000_prv_ts;

typedef struct mpu6000_outp_s
{
  // 3-Axis rotation [0.1 °/sec]
  int16_t rotX_p1degps_s16;
  int16_t rotY_p1degps_s16;
  int16_t rotZ_p1degps_s16;

} mpu6000_outp_ts;

typedef struct mpu6000_s
{
  mpu6000_prv_ts  prv_s;
  mpu6000_outp_ts outp_s;

} mpu6000_ts;

/****************** Public Data *****************/

MPU6000_SCOPE mpu6000_ts mpu6000_s;

/******************* Interface ******************/

MPU6000_SCOPE uint8_t mpu6000_init( void );
MPU6000_SCOPE void mpu6000( void );

#endif /* MPU6000_H_ */
