OhioIon/zynqFC/(commit log)

2018-11-07 Fixed DShot implementation Added DShot test-bench
    [dshot.vhd, dshot_AXIL.vhd, dshot_tb.vhd]
2018-11-09 - Reduced number of LUTs/FFs and improved WNS for DShot IP. Also improved TestBench. - With 100 MHz clock, DShot600 total bit time (1670 ns) is an integer multiple of 10 ns and hence we can stimulate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
    [dshot_tb.vhd]
2018-11-11 added Xilinx First Stage Boot Loader (FSBL) project. Added xilffs library to BSP (needed by FSBL). Removed _src folder in app.
2018-11-11 Adding initial version of KiCad 5.0.2 project
    [zynqAIO.sch, zynqAIO_Baro.sch, zynqAIO_CAM.sch, zynqAIO_GPS.sch, zynqAIO_IMU.sch, zynqAIO_Motor.sch, zynqAIO_PWR.sch, zynqAIO_RAM.sch]
2018-11-15 Improved DSHOT peripheral resource consumption by extracting bit-waveform generation into separate component - Allows to only have one bit-timing counter/comperator - Each DSHOT peripheral only needs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
    Added the other 3 DSHOT peripherals
    Fixed pin of DShot_0 to be equal to schematic
    [dshotWaveform.vhd, dshotWaveform_AXIL.vhd, dshotWaveform_tb.vhd, toplevel.vhd, toplevel.xdc]
2018-11-17 Initial version of dshot/dshotWaveform driver
    Removed driver from IP package so changes in .c/.h will not make IP core out-of-date -> C development should be possible without bitstream rebuild
    Fixed automatic base address determination by Xilinx toolchain
2018-11-17 User IP core drivers removed from BSP and added to app project via link
2018-11-17 Adding include paths for IP cores Checking build of drivers
2018-12-02 Fixed dshotWaveform driver
    - Will not continue initialization in case clock frequency register is 0
    - Fixed address offset of clock register
    /// DSHOT + DSHOTWAVEFORM successfully tested on Zybo devboard with Wraith 32 ESC (BLheli32) at DShot600 speed ///
2018-12-02 Driver successfully tested with DShot2400 speed
2019-02-09 Backup of current SW status.
    Components:
    - nrf24l01 allows to configure transceiver via SPI/GPIO.
    - et6i uses nrf24l01 to receive remote control from ESky ET6I 6 channel transmitter.
    - mpu6000 uses I²C to get current rotation rate.
    - Channel transforms µs PWM value in permille value.
    - Expo allows to add exponential function (smoother around stick center).
    - Arm monitors sticks for gesture to start the aircraft.
    - RateDes transforms permille value into desired rotation rate (gain).
    - PID is the rotation rate controller.
    Integration:
    - DevInp fetches all input signals.
    - Veh performs the signal processing.
    - DevOutp sets all output signals.
    - Bas performs the HAL
    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
2019-07-10 Improved driver structure and added comments.
2019-07-11 Fixed doxygen comments for dshotWaveform driver
2019-07-11 Added doxygen comments for dshot driver and cleaned-up implementation
2019-07-11 Added rotation matrix component because IMU sensor is not aligned on my test setup
2019-07-11 Added I²C peripheral to PL in order to read MPU 6050 on Zybo Board JB Pmod (upper row)
2019-07-11 Fixed gitignore. Updated BSP to include xiic driver.
2019-07-11 Fixing build issues and include paths for Release target
    [spi.c]
2019-07-11 Using Zybo board during developemnt. Switched PS7 config and using board-file.
2019-07-28 Fixed DShot pins to be on XADC Pmod (JA) on Zybo board.
    [zynqAIO_ZynqIoBankPl.sch]
2019-07-28 et6i driver - Added flag that indicates binding is in progress
    [et6i.c, et6i.h]
2019-07-28 Added a LED output driver that allows OFF, ON, BLINK-SLOW, BLINK-FAST. Using this driver to indicate TRX connection state on LD4 of Zybo.
2019-07-30 Header inclusion cleanup. Using C99 printf() instead of xilinx xil_printf(). Fixed PID initialization in Veh.c.
    [Bas.h, DevInp.c, DevInp.h, DevOutp.c, DevOutp.h, Veh.c, Veh.h]
2019-08-02 Removed Zybo board part. Not needed and complicates project setup.
    Configured DDR3 to 16-bit width (using only 1 of the 2 DDR3 chips on Zybo but aligned more to zynqFC configuration).
    Disabled Ethernet/USB. Not part of zynqFC.
    Enabled SPI0 peripheral for IMU, I²C1 peripheral for EEPROM and UART0 peripheral for GPS.
    However, all three interfaces cannot be used on Zybo and will not be used in SW.
    Updated HW pinning to current Zynq PS bank planning.
    [zynqAIO_Baro.sch, zynqAIO_GPS.sch, zynqAIO_IMU.sch, zynqAIO_RAM.sch, zynqAIO_ROM.sch, zynqAIO_ZynqIoBankPs.sch]
2019-08-02 Added text note about EEPROM chip device
    [zynqAIO_ROM.sch]
2019-08-02 Using EEPROM on Zybo board (EMIO into PL). Disabled SPI0 and UART, cannot be used anyway at the moment.
2019-08-02 Clear LED4 on connection loss
2019-08-02 Update driver package in BSP according to new FPGA configuration
2019-08-02 Read the EEPROM on Zybo board. Read the 48-bit MAC address contained in EEPROM.
    --> MAC address will be used in future during binding of zynqFC to zynqBase
    [Bas.c, Bas.h, iic.c, iic.h]
2019-08-05 1) Moved channel and rotation matrix to DevInp -> Interface between DevInp and Veh is now control value of axis in permille. 2) Added simple implementation of moving average filter. Using this to cal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
    [DevInp.c, DevInp.h, DevOutp.c, Veh.c, Veh.h, channel.c, channel.h]
2019-08-05 Using I²C device 0 of PS for IMU instead of using synthesized device in PL.
2019-08-06 Preparing interrupt based data transmission. Using Zybo PMOD JB4_N (W19 pin) as MPU-6000 interrupt pin.
2019-08-06 Using PS-IIC instead of PL-IIC for IMU -> Update BSP configuration as well
2019-08-06 Renamed EEPROM, MPU signals to better differentiate between GPIO and IIC. Added comment how TRX (nRF24L01 is connected to PS on Zybo board).
2019-08-08 Using timer interrupt to trigger task loop. Measure task loop time using CPU counter.
2019-08-08 I²C interface for IMU moved to iic.c. Finally SPI is planned but this eases up the interface now during development.
2019-08-08 Due to the slow data transmission rate of I²C, we will only fetch the minimum of data required for now. For the same reason, dynamic rate change is dropped for now. MPU driver now directly accesses I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
2019-08-08 Enabled RX_DR interrupt on device. Small cleanups.
2019-08-08 Fixed loop time to 8 kHz
    [main.h]
2019-08-08 Moved start of PID integral part to DevInp and renamed to start condition. MAF freeze is now also using the same signal.
2019-08-08 Improved debug output in case another TRX interferes with binding.
    [et6i.c]
2019-08-08 Switched IMU data transfer to interrupt mode
2019-08-08 Using SPI in interrupt mode. Data is still polled.
2019-08-11 Fixing warning notice. Array index was out of bound.
    [et6i.c]
2019-08-11 Changed variables that are accessed within interrupt and polled outside interrupt to type volatile. Otherwise release software with -O2 optimization won't function properly.
    [iic.c, spi.c, timer.h]
2019-08-11 Reduced TRX timeout value to 100 ms. ET6I is transmitting frames every 3 ms. Hence we will switch between both channels every 25 ms (each ~ 8 frames).
2019-08-11 Reduced default control loop gains by half. Had considerable oscillations on test flight.
    [Veh.c]
2019-08-11 Added BIF script to create bootimage for QSPI flash. Can be imported from SDK Xilinx->Create Boot Image menu.
    Bootimage contains First-Stage-Bootloader (Xilinx), FPGA Bitstream, and zynqFC application.
2020-02-21 Removed cycle time to 1 ms for testing. Removed integral part for now. Strong oscillations during flying. Reduced pitch/roll/yaw gain in drone model. Cyclic UART output only for DEBUG target.
    [DevOutp.c, Veh.c, main.h]
2021-02-22 Added comment which SPI hardware is used
2021-02-22 Improved start-up check by using register 0x04 to test SPI comm
2021-02-22 Added component to optionally enable UART output during debugging
